una1veritas/mac-floppy-emu/floppy-emu-source-1.0L-F11/eagle/floppyemu 1.1.1/board-layout.png

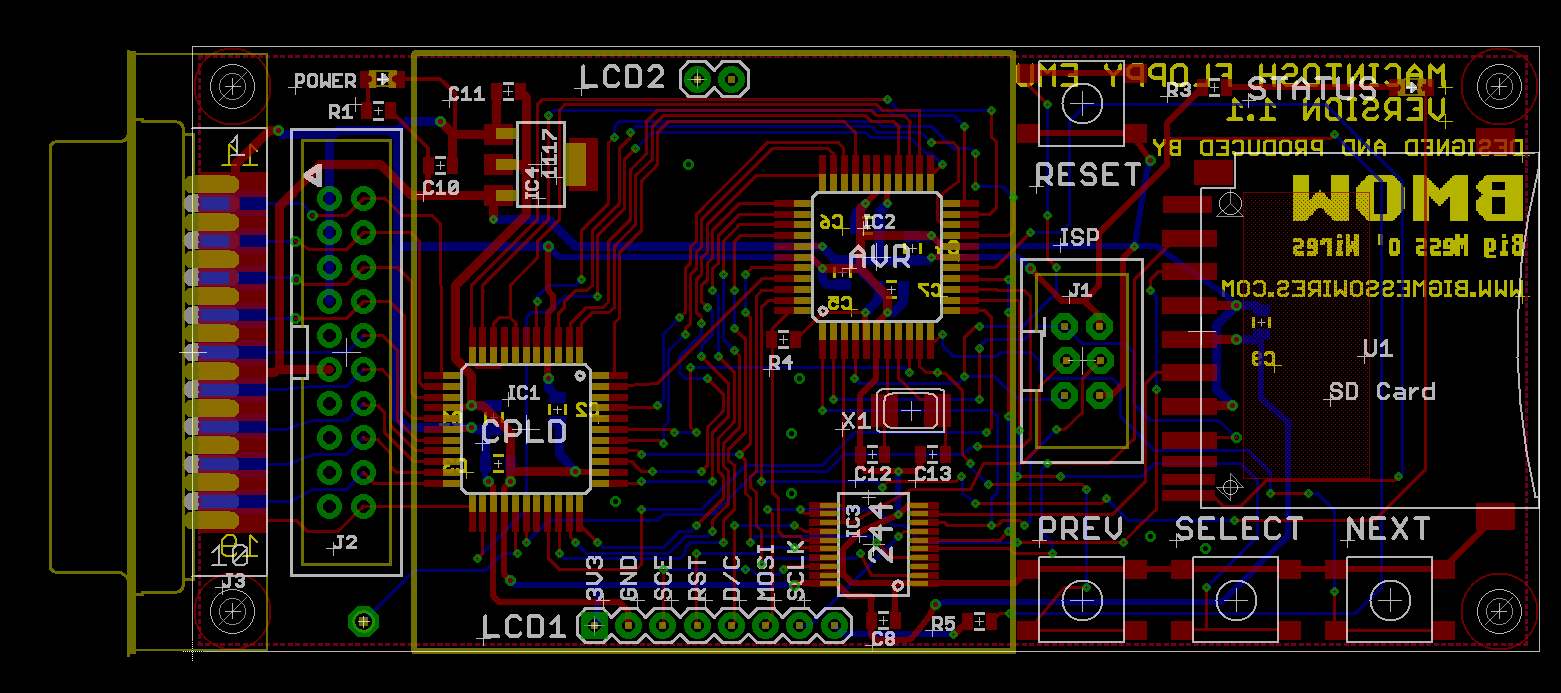
floppy-emu-source-1.0L-F11/eagle/floppyemu 1.1.1/board-layout.png
