una1veritas/mac-floppy-emu/floppy-emu-source-1.0L-F11/eagle/floppyemu 1.1.1/floppyemu.brd

## EAGLE design floppy-emu-source-1.0L-F11/eagle/floppyemu 1.1.1/floppyemu.brd (2014-07-10)

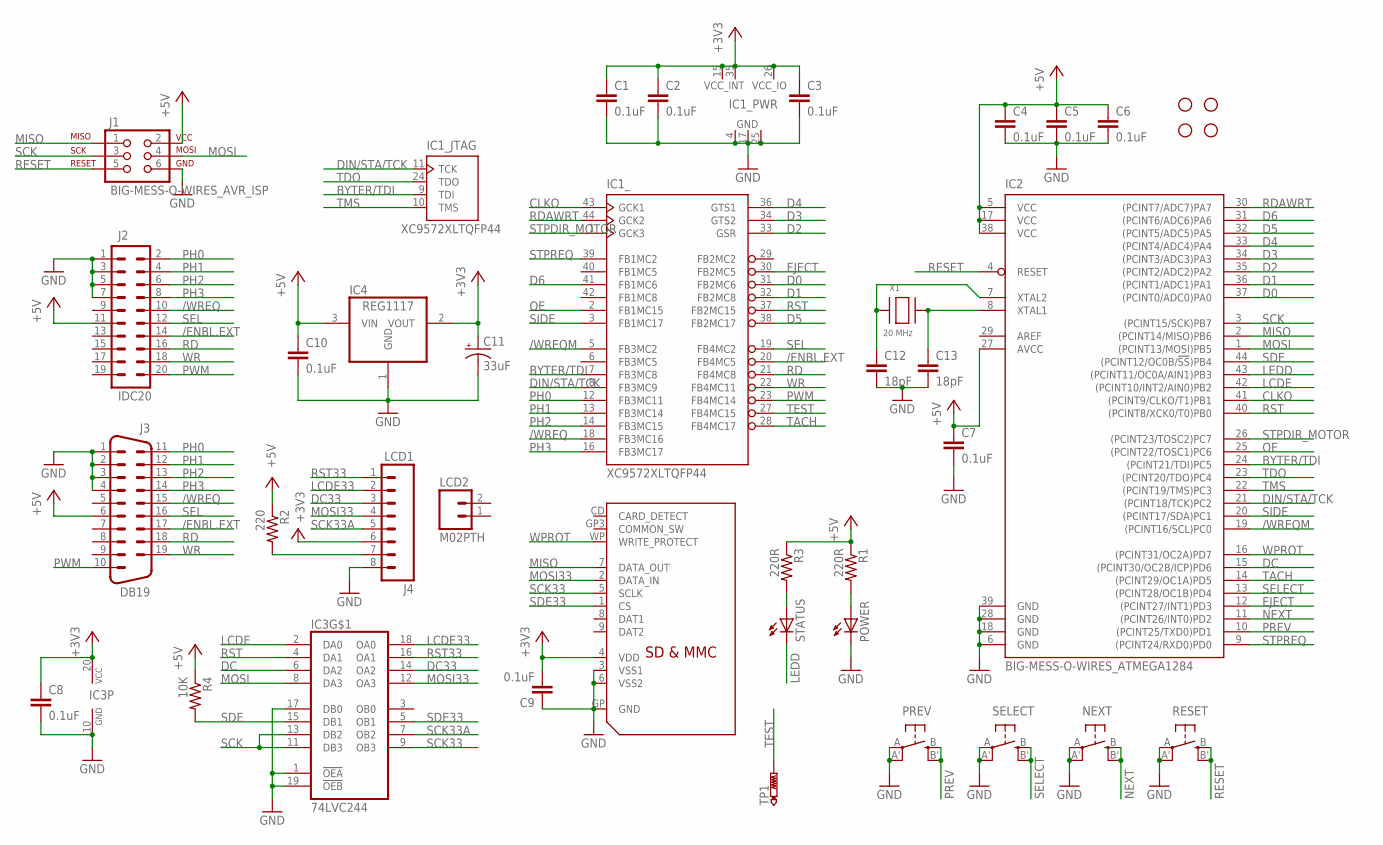
[picture p4: schematic floppyemu.sch]

Parts:
C1, C2, C3, C4, C5, C6, C7, C8, C9, C10: 0.1uF; 0805
C11: 33uF; EIA3528
C12, C13: 18pF; 0805
IC1: XC9572XLTQFP44; TQFP44-LONGPADS
IC2: BIG-MESS-O-WIRES_ATMEGA1284; BIG-MESS-O-WIRES_TQFP44-LONGPADS
IC3: 74LVC244; SSOP20
IC4: REG1117; SOT223
J1: BIG-MESS-O-WIRES_AVR_ISP; BIG-MESS-O-WIRES_2X3-SHROUDED
J2: IDC20
J3: DB19; DB19EDGE
J4: LCD1; 1X08
LCD2: M02PTH; 1X02
NEXT: B3FS-10XX; B3FS
POWER: LEDCHIPLED_0805; CHIPLED_0805
PREV: B3FS-10XX; B3FS
R1, R3: 220R; 0805
R2: 220; 1/6W-RES
R4: 10K; 0805
RESET: B3FS-10XX; B3FS
SELECT: B3FS-10XX; B3FS
STANDOFF1, STANDOFF2, STANDOFF3, STANDOFF4: STAND-OFF
STATUS: LEDCHIPLED_0805; CHIPLED_0805
TP1: PTR1PAD1-13; P1-13
U1: ADAFRUIT_SDMMC06132; ADAFRUIT_06132
X1: 20 MHz; NX5032

Connections:
+3V3: C1.1, C2.1, C3.1, C8.1, C9.2, C11.A (+), IC1.15 (VCC_INT), IC1.26 (VCC_IO), IC1.35 (VCC_INT), IC3.20 (VCC), IC4.2 (VOUT), J4.6, U1.4 (VDD)
+5V: C4.1, C5.1, C6.1, C7.1, C10.1, IC2.5 (VCC), IC2.17 (VCC), IC2.27 (AVCC), IC2.38 (VCC), IC4.3 (VIN), J1.2, J2.11, J3.6, R1.1, R2.1, R3.1, R4.1
/ENBL.EXT: IC1.20 (FB4MC5), J2.14, J3.17
/WREQ: IC1.18 (FB3MC16), J2.10, J3.15
/WREQM: IC1.5 (FB3MC2), IC2.19 ((PCINT16/SCL)PC0)
BYTER/TDI: IC1.7 (FB3MC8), IC1.9 (TDI), IC2.24 ((PCINT21/TDI)PC5)
CLKO: IC1.43 (GCK1), IC2.41 ((PCINT9/CLKO/T1)PB1)
D0: IC1.31 (FB2MC6), IC2.37 ((PCINT0/ADC0)PA0)
D1: IC1.32 (FB2MC8), IC2.36 ((PCINT1/ADC1)PA1)
D2: IC1.33 (GSR), IC2.35 ((PCINT2/ADC2)PA2)
D3: IC1.34 (GTS2), IC2.34 ((PCINT3/ADC3)PA3)
D4: IC1.36 (GTS1), IC2.33 ((PCINT4/ADC4)PA4)
D5: IC1.38 (FB2MC17), IC2.32 ((PCINT5/ADC5)PA5)
D6: IC1.41 (FB1MC6), IC2.31 ((PCINT6/ADC6)PA6)
DC: IC2.15 ((PCINT30/OC2B/ICP)PD6), IC3.6 (DA2)
DC33: IC3.14 (OA2), J4.3
DIN/STA/TCK: IC1.8 (FB3MC9), IC1.11 (TCK), IC2.21 ((PCINT18/TCK)PC2)
EJECT: IC1.30 (FB2MC5), IC2.12 ((PCINT27/INT1)PD3)
GND: C1.2, C2.2, C3.2, C4.2, C5.2, C6.2, C7.2, C8.2, C9.1, C10.2, C11.C (-), C12.2, C13.2, IC1.4 (GND), IC1.17 (GND), IC1.25 (GND), IC2.6 (GND), IC2.18 (GND), IC2.28 (GND), IC2.39 (GND), IC3.1 (!OEA), IC3.10 (GND), IC3.17 (DB0), IC3.19 (!OEB), IC4.1 (GND), J1.6, J2.1, J2.3, J2.5, J2.7, J3.1, J3.2, J3.3, J3.4, J4.8, NEXT.A, NEXT.A', POWER.C, PREV.A, PREV.A', RESET.A, RESET.A', SELECT.A, SELECT.A', U1.3 (VSS1), U1.6 (VSS2), U1.GP (GND)
LCDE: IC2.42 ((PCINT10/INT2/AIN0)PB2), IC3.2 (DA0)
LCDE33: IC3.18 (OA0), J4.2
LEDD: IC2.43 ((PCINT11/OC0A/AIN1)PB3), STATUS.C
MISO: IC2.2 ((PCINT14/MISO)PB6), J1.1, U1.7 (DATA_OUT)
MOSI: IC2.1 ((PCINT13/MOSI)PB5), IC3.8 (DA3), J1.4
MOSI33: IC3.12 (OA3), J4.4, U1.2 (DATA_IN)
unnamed: C13.1, IC2.8 (XTAL1), X1.P$2
unnamed: POWER.A, R1.2
unnamed: C12.1, IC2.7 (XTAL2), X1.P$1
unnamed: R3.2, STATUS.A
unnamed: J4.7, R2.2
NEXT: IC2.11 ((PCINT26/INT0)PD2), NEXT.B, NEXT.B'
OE: IC1.2 (FB1MC15), IC2.25 ((PCINT22/TOSC1)PC6)
PH0: IC1.12 (FB3MC11), J2.2, J3.11
PH1: IC1.13 (FB3MC14), J2.4, J3.12
PH2: IC1.14 (FB3MC15), J2.6, J3.13
PH3: IC1.16 (FB3MC17), J2.8, J3.14
PREV: IC2.10 ((PCINT25/TXD0)PD1), PREV.B, PREV.B'
PWM: IC1.23 (FB4MC14), J2.20, J3.10
RD: IC1.21 (FB4MC8), J2.16, J3.18
RDAWRT: IC1.44 (GCK2), IC2.30 ((PCINT7/ADC7)PA7)
RESET: IC2.4 (RESET), J1.5, RESET.B, RESET.B'
RST: IC1.37 (FB2MC15), IC2.40 ((PCINT8/XCK0/T0)PB0), IC3.4 (DA1)
RST33: IC3.16 (OA1), J4.1
SCK: IC2.3 ((PCINT15/SCK)PB7), IC3.11 (DB3), IC3.13 (DB2), J1.3
SCK33: IC3.9 (OB3), U1.5 (SCLK)
SCK33A: IC3.7 (OB2), J4.5
SDE: IC2.44 ((PCINT12/OC0B/!SS!)PB4), IC3.15 (DB1), R4.2
SDE33: IC3.5 (OB1), U1.1 (CS)
SEL: IC1.19 (FB4MC2), J2.12, J3.16
SELECT: IC2.13 ((PCINT28/OC1B)PD4), SELECT.B, SELECT.B'
SIDE: IC1.3 (FB1MC17), IC2.20 ((PCINT17/SDA)PC1)
STPDIR_MOTOR: IC1.1 (GCK3), IC2.26 ((PCINT23/TOSC2)PC7)
STPREQ: IC1.39 (FB1MC2), IC2.9 ((PCINT24/RXD0)PD0)
TACH: IC1.28 (FB4MC17), IC2.14 ((PCINT29/OC1A)PD5)
TDO: IC1.24 (TDO), IC2.23 ((PCINT20/TDO)PC4)
TEST: IC1.27 (FB4MC15), TP1.TP
TMS: IC1.10 (TMS), IC2.22 ((PCINT19/TMS)PC3)
WPROT: IC2.16 ((PCINT31/OC2A)PD7), U1.WP (WRITE_PROTECT)
WR: IC1.22 (FB4MC11), J2.18, J3.19

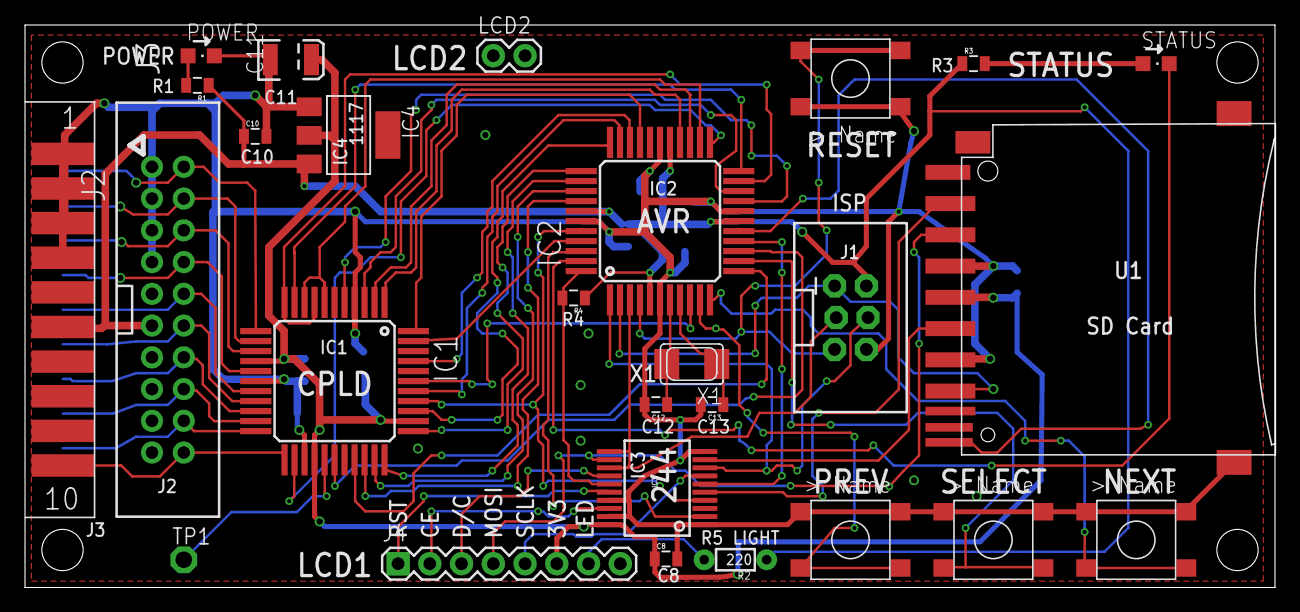
[picture p5: board floppyemu.brd from above]

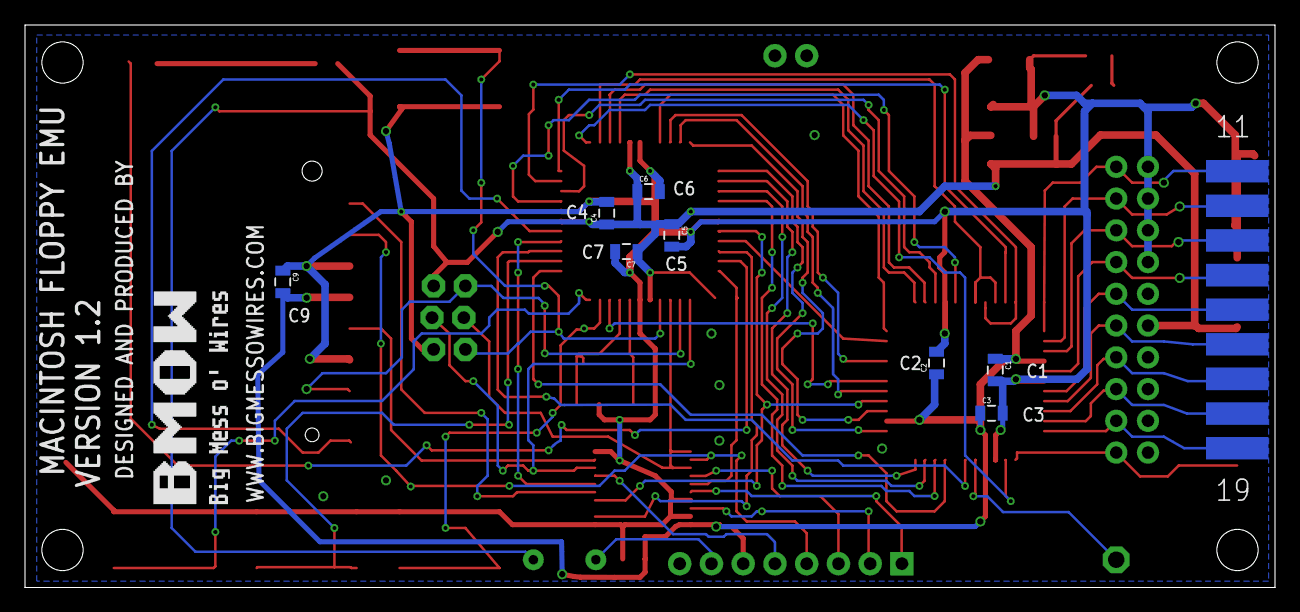
[picture p6: board floppyemu.brd from below]

Board: 2 copper layers, 100.0 x 45.0 mm, 39 parts (8 on the bottom side), 59 nets.
