una1veritas/mac-floppy-emu/(commit log)

2014-07-10 My first
    [floppyemu.brd, floppyemu.sch]
2014-07-12 floppy-emu organized
    [floppyemu.brd, floppyemu.sch]
